mppowell/midi-controller/Layout-01.png

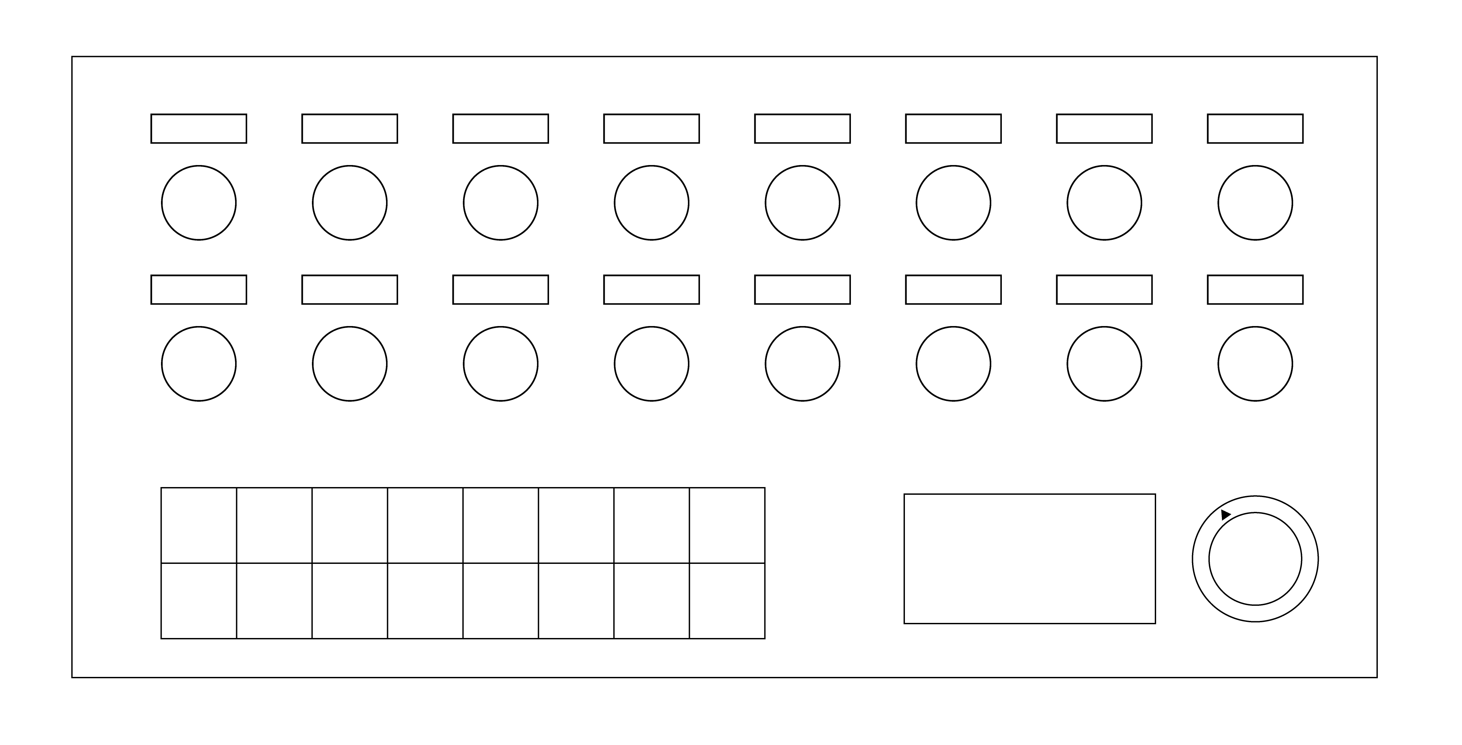
Layout-01.png
