mppowell/midi-controller/Layout_v2-01.png

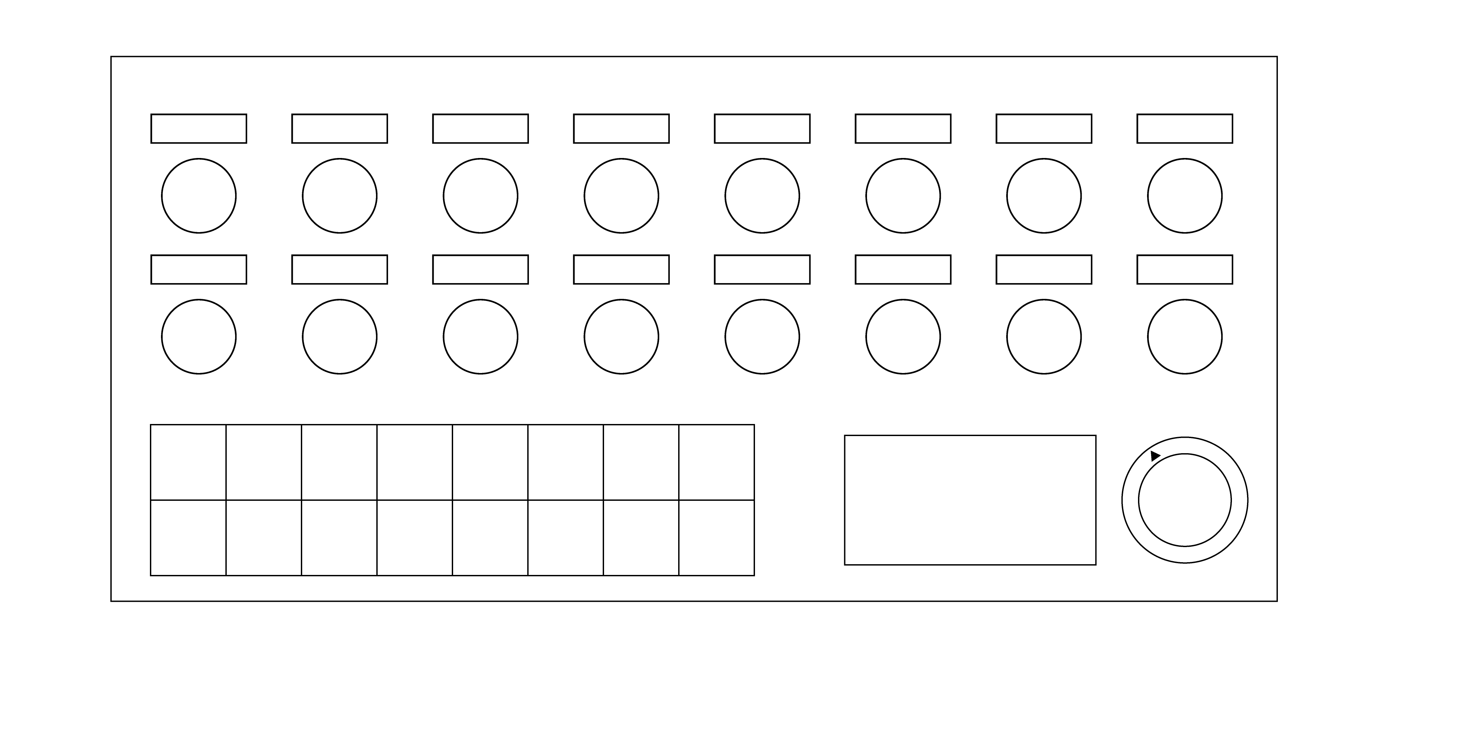
Layout_v2-01.png
