mppowell/midi-controller/PCB_Design/BOM.xlsx

# | Reference | Qty | Value | Footprint | DNP
1 | D1, D2, D3, D4, D5, D6, D7, D8, D9, D10, D11, D12, D13, D14, D15, D16, D17, D18, D19, D20, D21, D22, D23, D24 | 24 | D_Small_Filled | Diode_SMD:D_SOD-123 | x
2 | H1, H2, H3, H4, H5, H6, H7, H8 | 8 | MountingHole_Pad_M2.5 | MPP_MountingHole:MountingHole_M2.5
3 | J1, J2, J3 | 3 | Conn_01x15_Socket | Connector_FFC-FPC:Hirose_FH12-15S-0.5SH_1x15-1MP_P0.50mm_Horizontal | x
4 | J4 | 1 | Conn_01x40_Socket | Connector_FFC-FPC:Hirose_FH12-40S-0.5SH_1x40-1MP_P0.50mm_Horizontal | x
5 | RV1, RV2, RV3, RV4, RV5, RV6, RV7, RV8, RV9, RV10, RV11, RV12, RV13, RV14, RV15, RV16, RV17, RV18, RV19, RV20, RV21, RV22, RV23, RV24 | 24 | RV142FPF-40B1 | MPP_Potentiometer_THT:RV142FPF-40B1
6 | U1, U2, U3, U4, U5, U6 | 6 | TMUX1209_TSSOP | Package_SO:TSSOP-16_4.4x5mm_P0.65mm | x
7 | U7 | 1 | 74HC164 | Package_SO:SO-14_3.9x8.65mm_P1.27mm | x
8 | U8, U9 | 2 | CD74HC154_SOIC | Package_SO:SOIC-24W_7.5x15.4mm_P1.27mm | x
9 | U10 | 1 | 74LVC1G04 | Package_TO_SOT_SMD:SOT-23-5_HandSoldering | x
# | Reference | Qty | Value | Footprint | DNP
1 | A1 | 1 | Teensy_4.1_THT | MPP_Module:Teensy_4.1_THT
2 | C1 | 1 | 10uF, 50V, 20% | Capacitor_SMD:C_1210_3225Metric_Pad1.33x2.70mm_HandSolder | x
3 | C2 | 1 | 0.1uF, 25V, 5% | Capacitor_SMD:C_0805_2012Metric_Pad1.18x1.45mm_HandSolder | x
4 | C3, C4 | 2 | 22uF, 6.3V, 20% | Capacitor_SMD:C_0805_2012Metric_Pad1.18x1.45mm_HandSolder | x
5 | D1 | 1 | RED | LED_SMD:LED_0805_2012Metric_Pad1.15x1.40mm_HandSolder | x
6 | DS1 | 1 | ADAFRUIT_2IN_IPS_MODULE | MPP_Display:ADAFRUIT_2IN_IPS_MODULE | x
7 | H1, H2, H3, H4, H5, H6 | 6 | MountingHole_Pad_M2.5 | MPP_MountingHole:MountingHole_M2.5
8 | J1 | 1 | Conn_01x40_Socket | Connector_FFC-FPC:Hirose_FH12-40S-0.5SH_1x40-1MP_P0.50mm_Horizontal | x
9 | J2 | 1 | Barrel_Jack_Switch | Connector_BarrelJack:BarrelJack_Horizontal | x
10 | L1 | 1 | 4.7uH, 2.7A, 100mOhm | Inductor_SMD:L_Taiyo-Yuden_NR-60xx_HandSoldering | x
11 | R1, R2, R3, R4 | 4 | 10k | Resistor_SMD:R_0805_2012Metric_Pad1.20x1.40mm_HandSolder | x
12 | R5 | 1 | 1k | Resistor_SMD:R_0805_2012Metric_Pad1.20x1.40mm_HandSolder | x
13 | SW1 | 1 | EN16AB-HB | MPP_Rotary_Encoder:EN16AB-HB | x
14 | U1 | 1 | AP63203WU | Package_TO_SOT_SMD:TSOT-23-6 | x
# | Reference | Qty | Value | Footprint | DNP
1 | DS1, DS2, DS3, DS4, DS5, DS6, DS7, DS8 | 8 | CFAL12832C-0091B-W | MPP_Display:CFAL12832C-0091B-W
2 | H1, H2 | 2 | MountingHole_Pad_M2.5 | MPP_MountingHole:MountingHole_M2.5
3 | J1 | 1 | Conn_01x15_Socket | Connector_FFC-FPC:Hirose_FH12-15S-0.5SH_1x15-1MP_P0.50mm_Horizontal | x
