mppowell/midi-controller/PCB_Design/reference_materials/Sparkfun_PowerCircuit.png

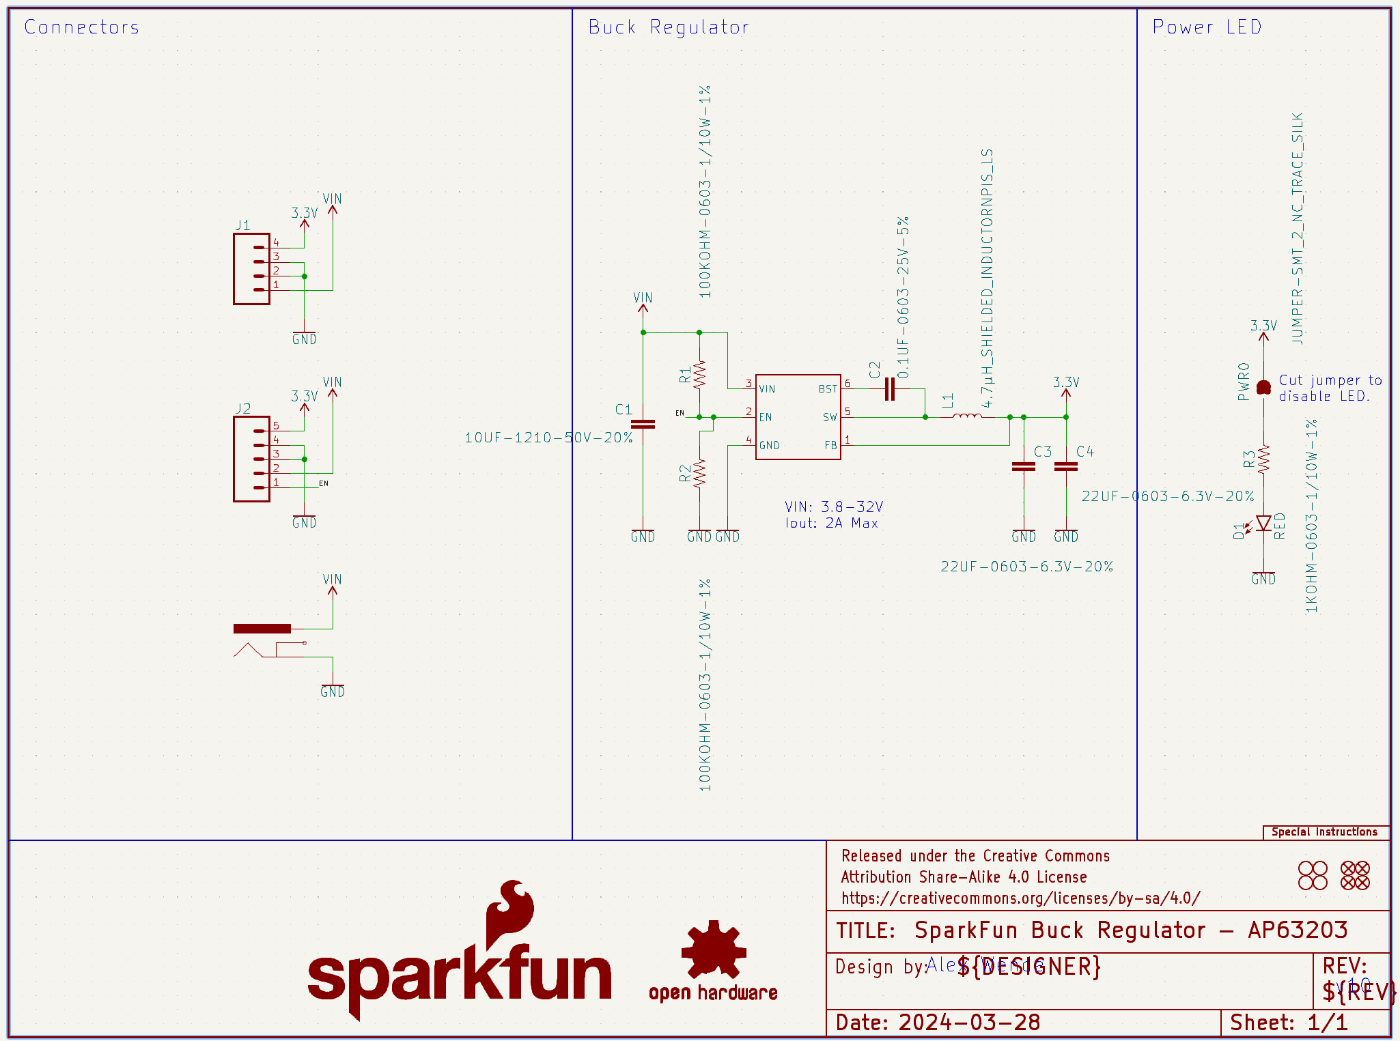
PCB_Design/reference_materials/Sparkfun_PowerCircuit.png
