mppowell/midi-controller/PCB_Models/Assembly/midi-controller_assembly-Pot.step

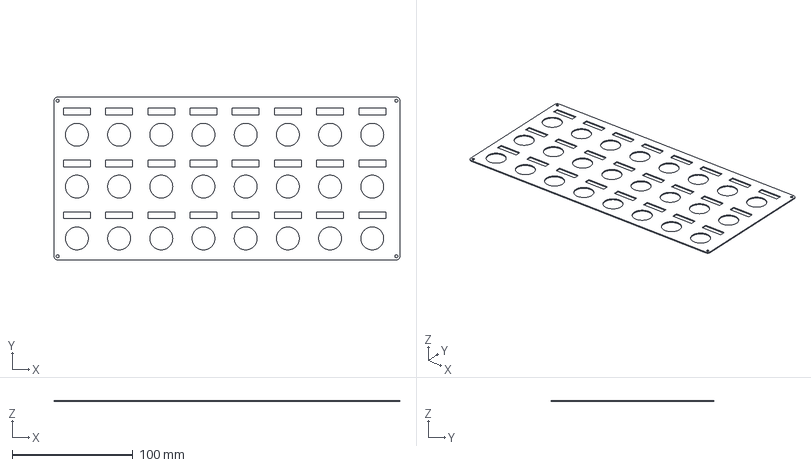
[picture p9: CAD file, 2024-06-23]
PCB_Models/Assembly/midi-controller_assembly-Pot.step
287.0 x 135.0 x 1.00 mm
