mppowell/midi-controller/PCB_Models/Assembly/midi-controller_assembly.FCStd

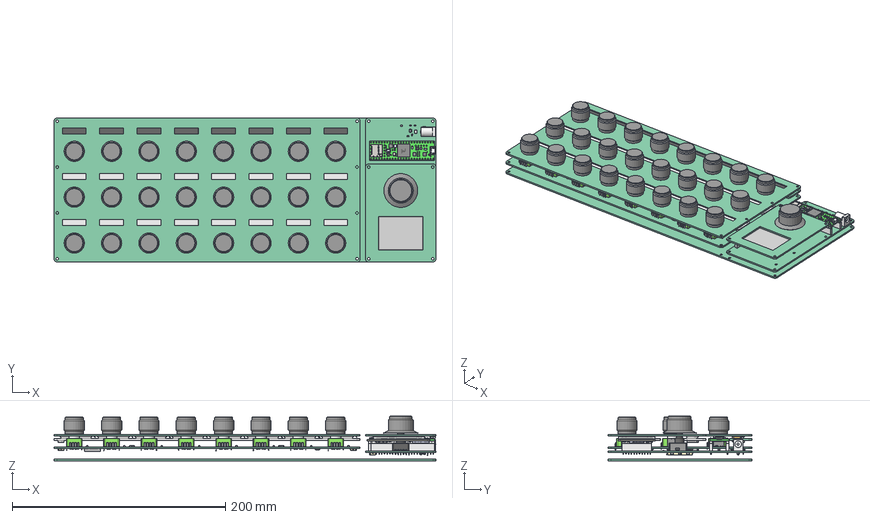
[picture p10: CAD file, 2024-06-23]
PCB_Models/Assembly/midi-controller_assembly.FCStd
358.0 x 135.0 x 41.9 mm
Pcb_732a
Panel x 8
Display x 8
Cable x 8
FoamPad x 8
lock x 8
pins x 8
lock001
pins001
midi-controller_oled-board_teensy001
midi-controller_oled-board_teensy002
Pcb_85c2
Pcb_93cb
Pcb_7e6a
PCB, Teensy 4.1
SMD Capacitor, Configurable, Teensy 4.1_C8
SMD Capacitor, Configurable, Teensy 4.1_C009
SMD Capacitor, Configurable, Teensy 4.1_C010
SMD Capacitor, Configurable, Teensy 4.1_C9
SMD Capacitor, Configurable, Teensy 4.1_C012
SMD Capacitor, Configurable, Teensy 4.1_C013
SMD Capacitor, Configurable, Teensy 4.1_C29
SMD Capacitor, Configurable, Teensy 4.1_C015
SMD Capacitor, Configurable, Teensy 4.1_C016
SMD Capacitor, Configurable, Teensy 4.1_C13
SMD Capacitor, Configurable, Teensy 4.1_C018
SMD Capacitor, Configurable, Teensy 4.1_C019
SMD Capacitor, Configurable, Teensy 4.1_C12
SMD Capacitor, Configurable, Teensy 4.1_C021
SMD Capacitor, Configurable, Teensy 4.1_C022
SMD Capacitor, Configurable, Teensy 4.1_C6
SMD Capacitor, Configurable, Teensy 4.1_C024
SMD Capacitor, Configurable, Teensy 4.1_C025
SMD Capacitor, Configurable, Teensy 4.1_C5
SMD Capacitor, Configurable, Teensy 4.1_C027
SMD Capacitor, Configurable, Teensy 4.1_C028
SMD Capacitor, Configurable, Teensy 4.1_C11
SMD Capacitor, Configurable, Teensy 4.1_C030
SMD Capacitor, Configurable, Teensy 4.1_C031
SMD Capacitor, Configurable, Teensy 4.1_C22
SMD Capacitor, Configurable, Teensy 4.1_C033
SMD Capacitor, Configurable, Teensy 4.1_C034
SMD Capacitor, Configurable, Teensy 4.1_C23
SMD Capacitor, Configurable, Teensy 4.1_C036
SMD Capacitor, Configurable, Teensy 4.1_C037
SMD Capacitor, Configurable, Teensy 4.1_C14
SMD Capacitor, Configurable, Teensy 4.1_C039
SMD Capacitor, Configurable, Teensy 4.1_C040
SMD Capacitor, Configurable, Teensy 4.1_C16
SMD Capacitor, Configurable, Teensy 4.1_C042
SMD Capacitor, Configurable, Teensy 4.1_C043
SMD Capacitor, Configurable, Teensy 4.1_C17
SMD Capacitor, Configurable, Teensy 4.1_C045
SMD Capacitor, Configurable, Teensy 4.1_C046
SMD Capacitor, Configurable, Teensy 4.1_C20
SMD Capacitor, Configurable, Teensy 4.1_C048
SMD Capacitor, Configurable, Teensy 4.1_C049
SMD Capacitor, Configurable, Teensy 4.1_C21
SMD Capacitor, Configurable, Teensy 4.1_C051
SMD Capacitor, Configurable, Teensy 4.1_C052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
