mppowell/midi-controller/PCB_Models/Adafruit_2_IPS/3D/4311 2in TFT IPS Display.step

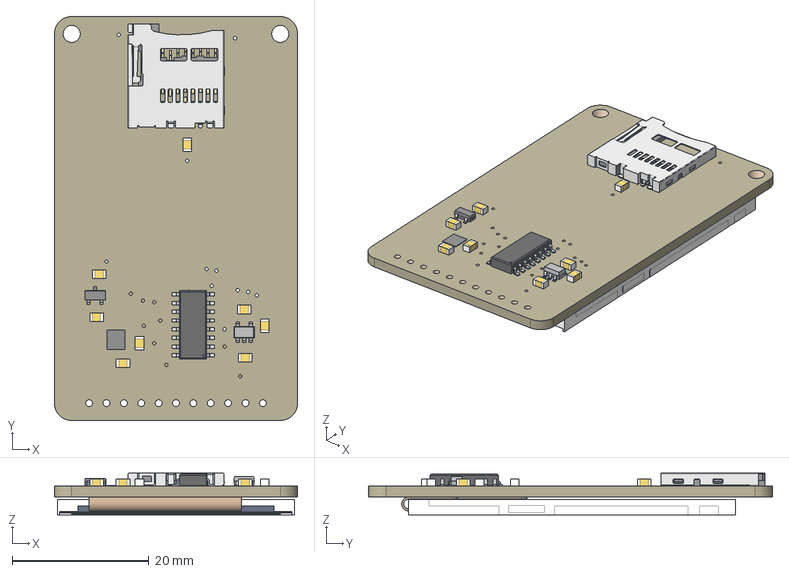
[picture p11: CAD file, 2024-06-23]
PCB_Models/Adafruit_2_IPS/3D/4311 2in TFT IPS Display.step
35.6 x 59.1 x 6.08 mm
Board
10K x 8
AP2112K-3.3
74HC4050D
MICROSD
BSS138
DISP_LCD_GENERIC_SPI_2.0IN_240X320
APX803-SAG
