mppowell/midi-controller/PCB_Models/Assembly/Faceplate.FCStd

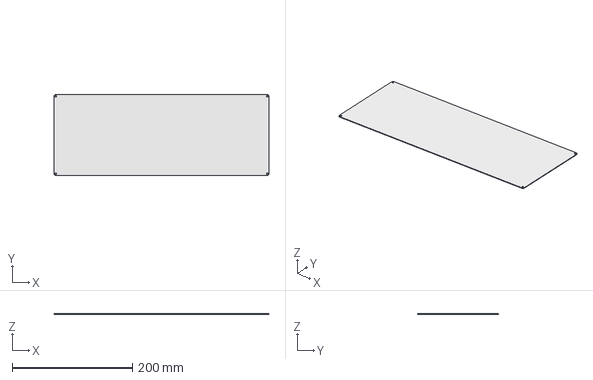
[picture p12: CAD file, 2024-06-23]
PCB_Models/Assembly/Faceplate.FCStd
358.0 x 135.0 x 1.00 mm
