mppowell/midi-controller/PCB_Models/Adafruit_2.8TFT Grabcad/Adafruit 2.8TFT.STEP

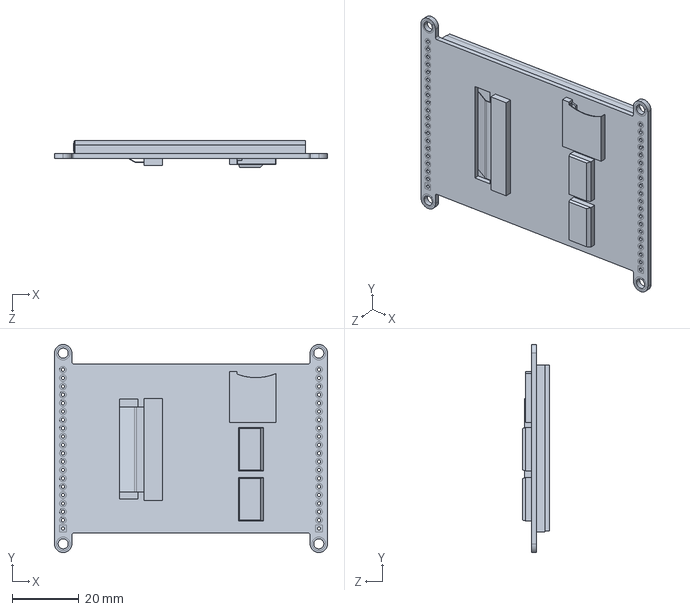
[picture p13: CAD file, 2024-06-23]
PCB_Models/Adafruit_2.8TFT Grabcad/Adafruit 2.8TFT.STEP
81.7 x 62.2 x 8.00 mm
