mppowell/midi-controller/(list of files, cad)

Other CAD files:
PCB_Models/Adafruit_2.8TFT Grabcad/Adafruit 2.8TFT.SLDPRT
PCB_Models/Adafruit_2_IPS/3D/4311 2in TFT IPS Display.f3d
PCB_Models/Adafruit_2_IPS/3D/4311 2in TFT IPS Display.stl
