mppowell/midi-controller/(threads)

Thread 1 (2024-08-12):

Limited number of OLED screens working at once

mppowell, 2024-08-12:
When attaching a single row of OLED displays (using version 1 of the OLED board), the displays work as intended. However, when I attached a 2nd or 3rd row of OLEDs, none of them would turn on.

mppowell, 2024-08-12:
To test if it was a problem with the whole OLED board, I added one OLED to the second row at a time. After 4-5 OLEDs in the second row, the displays started to glitch. So it didn't seem to be a problem inherent to having 2 rows hooked up to the mainboard, but rather a limitation on the number of OLEDs that could be connected at once.

mppowell, 2024-08-12:
I reduced the data rate of the SPI bus to see if a slower signal would be more robust. I got more screens working at once, and was able to get something to show up on all the screens but the data still looked corrupted. This strengthens my opinion that the issue has to do with loading on the SPI lines.

mppowell, 2024-08-12:
To resolve this issue, I redesigned the OLED board to include a buffer on the SPI lines and increase the impedance seen by the microcontroller pins.

Thread 2 (2024-08-12):

OLED board version 2 does not display more than 1 row at a time

mppowell, 2024-08-12:
After redesigning the OLED board to resolve previous issue, I again found that connecting the second row of OLEDs resulted in none of the OLEDs working properly. They would produce a strange, corrupted text, and nothing showed up on the IPS display (which led me ultimately to the answer). When I would turn the page selection encoder, the text would shift by a regular amount each time I would flip it back. This no longer seemed like SPI corruption but rather that the cursor or display size was getting mishandled.
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

mppowell, 2024-08-12:
When I commented out all code related to the IPS display, I discovered that all the OLEDs actually worked! This eliminated the idea that the issue was related to SPI corruption and it eliminated concerns over there not being sufficient power to turn on the screens. When I started to add IPS functionality back in, the OLEDs broke again almost immediately. Even just initializing the IPS display caused the corrupted view to return.

Interestingly, during this initialization, the screen resolution is configured. And the IPS screen resolution is different from that of the OLED screens. Both libraries, call the Adafruit_GFX library, so I wondered if perhaps a global variable related to the screen resolution was being overwritten that caused the cursor to end up in the wrong position for the OLEDs each time they got overwritten.

mppowell, 2024-08-12:
I discovered the bug which took 2 critical steps. First, when initializing the IPS display, I needed to put it into "SPI_MODE2" (by default it is set to SPI_MODE0). However, I can't find anywhere in the documentation for this display that it uses SPI_MODE2, nor did it have any issue in SPI_MODE0 when used alone, or even with one row of the OLEDs. So I don't fully understand why this worked.

This worked, but resulted in the box showing the selected page on the menu, not to be reset when changing the page. To resolve this issue, I had to re-call the set-rotation function each time I updated the IPS display. I assume this puts the cursor in the correct spot before making any changes.

The issue is resolved, but I am not entirely sure why...

Closed 2024-08-12.
