mppowell/midi-controller/PCB_Illustrations/midi-controller_pot-subcircuit_diagram/midi-controller_pot-subcircuit_diagram.kicad_pcb

## KiCad design ECB_FirstDraftSchematic/ECB_FirstDraft.kicad_sch

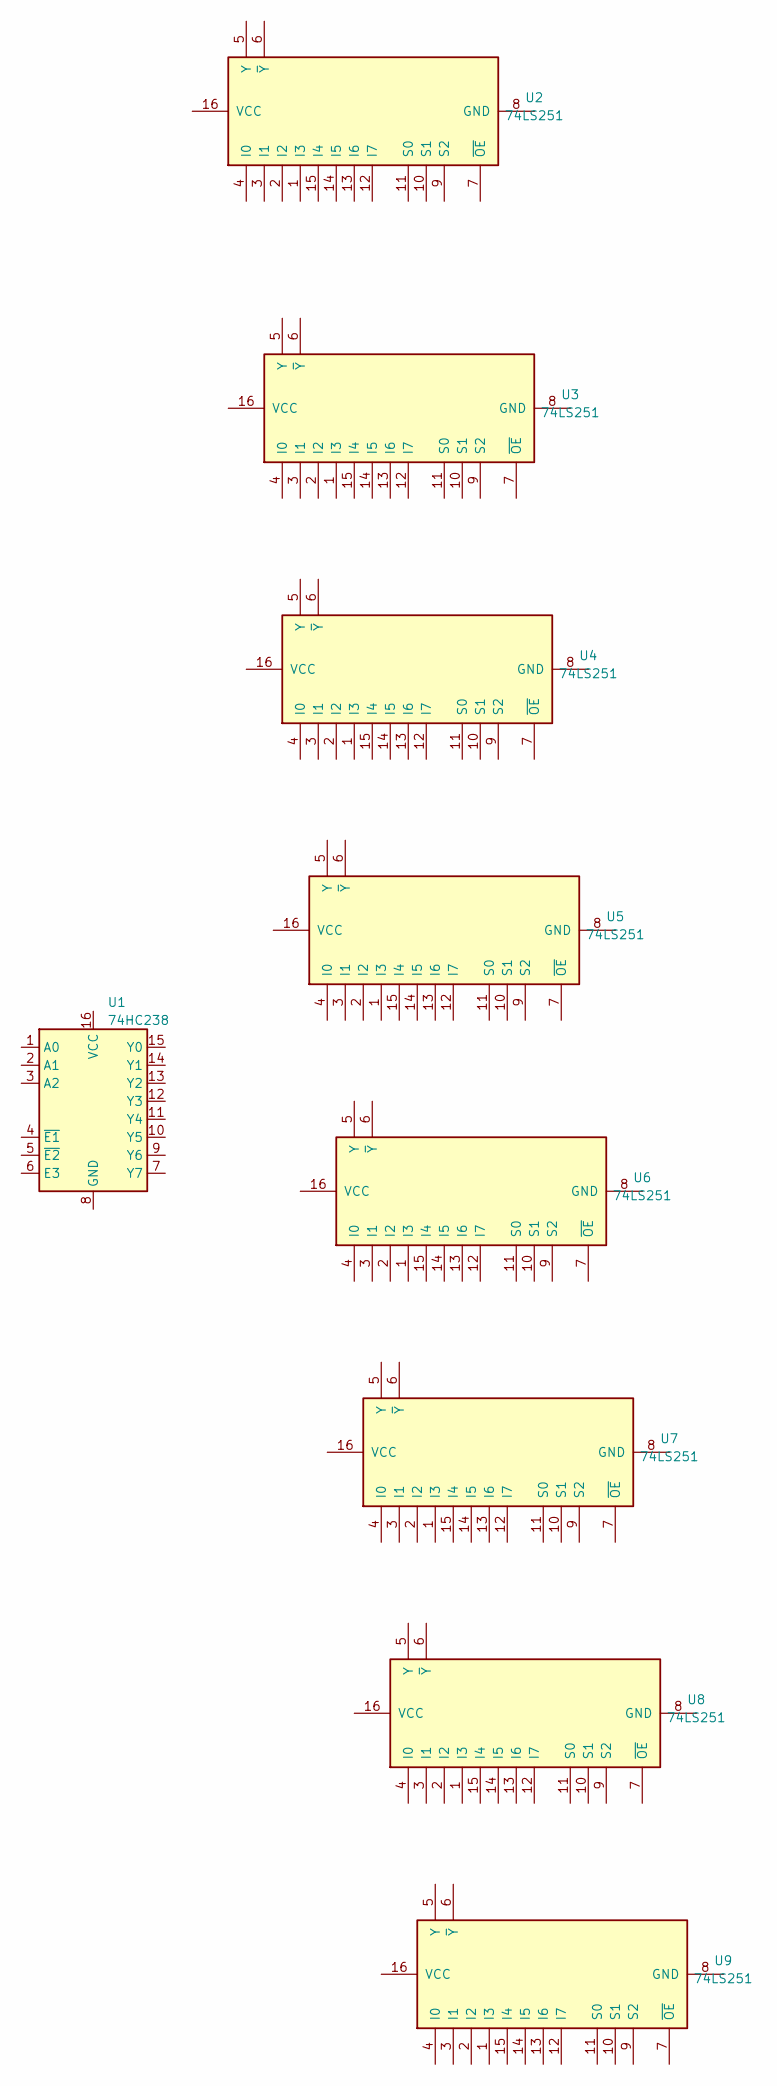
[picture p14: schematic ECB_FirstDraft.kicad_sch]

Parts:
U1: 74HC238
U2, U3, U4, U5, U6, U7, U8, U9: 74LS251
