mppowell/midi-controller/PCB_Models/Adafruit_2_IPS/Eagle/Adafruit-2.0-inch-240x320-TFT-PCB-master/Adafruit-2.0-inch-240x320-TFT-PCB-master/Adafruit 2.0 inch 240x320 IPS TFT.brd

## EAGLE design PCB_Models/Adafruit_2_IPS/Eagle/Adafruit-2.0-inch-240x320-TFT-PCB-master/Adafruit-2.0-inch-240x320-TFT-PCB-master/Adafruit 2.0 inch 240x320 IPS TFT.brd (2024-06-23)

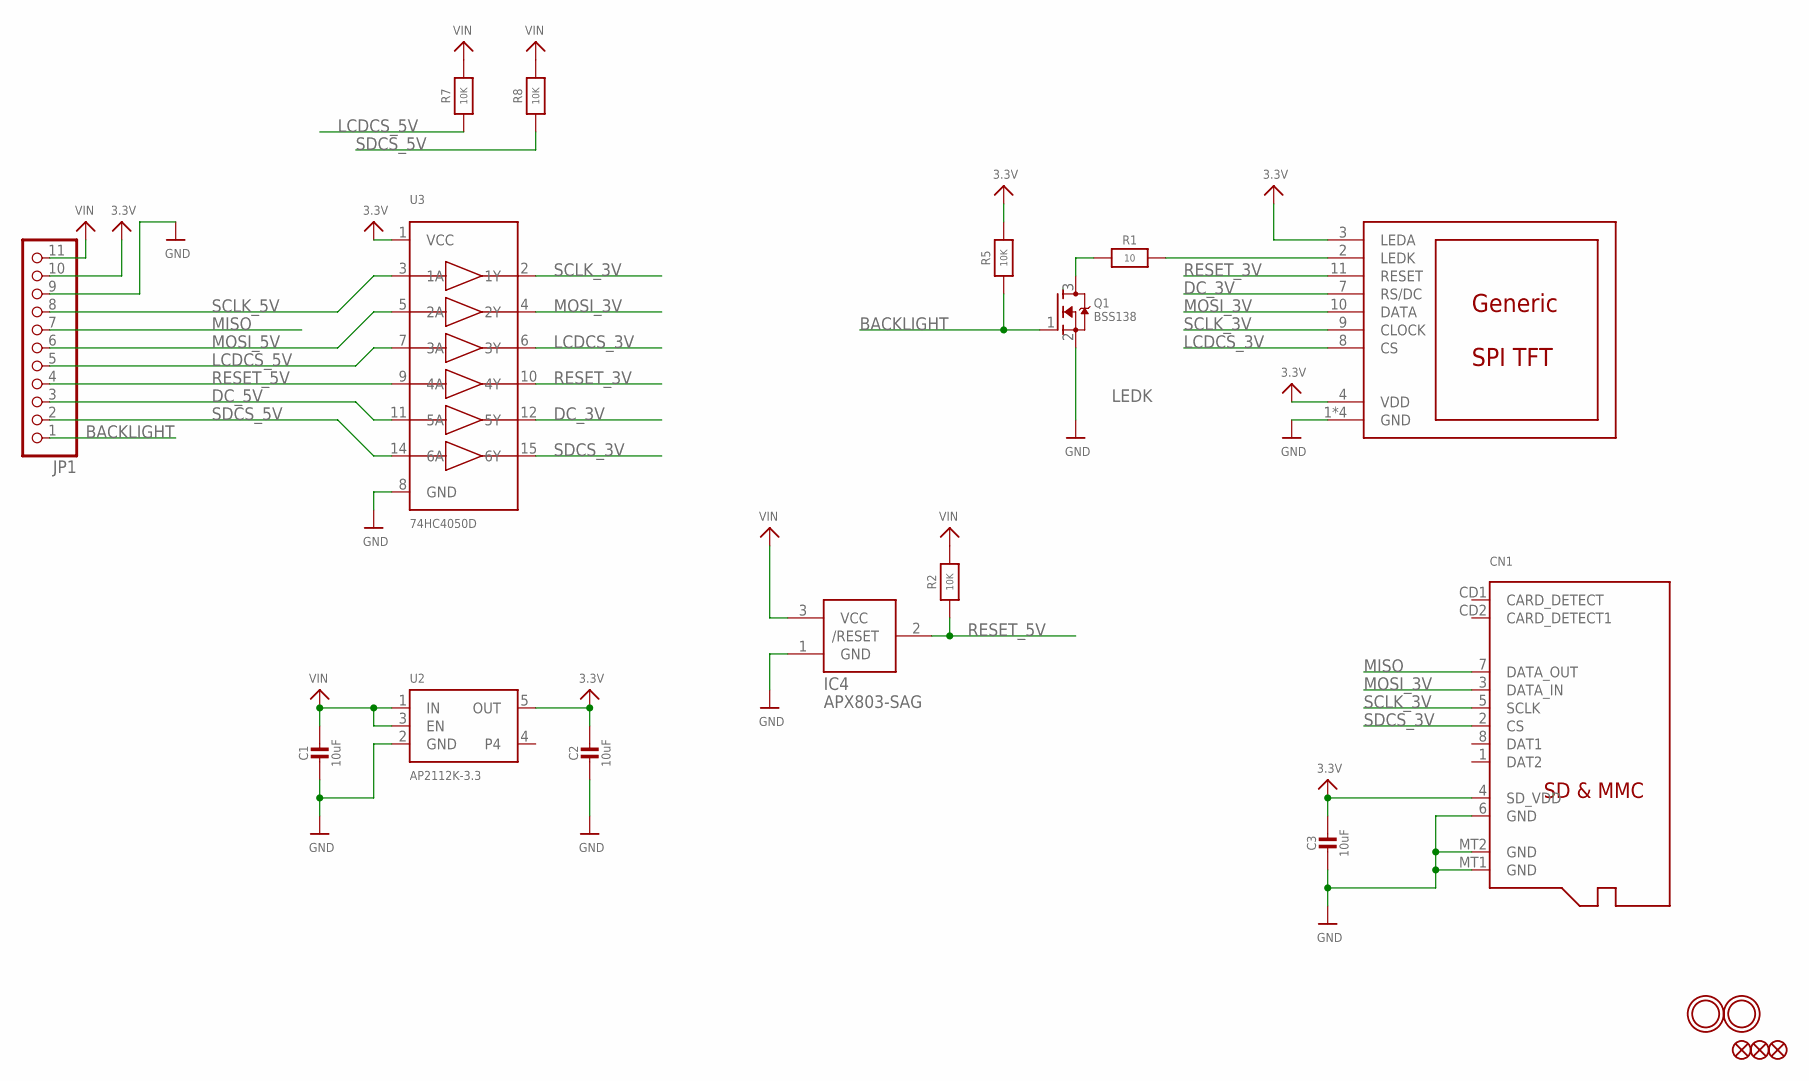
[picture p15: schematic Adafruit 2.0 inch 240x320 IPS TFT.sch]

Parts:
C1, C2, C3: 10uF; 0805-NO
CN1: MICROSD
DISP1: DISP_LCD_GENERIC_SPI_2.0IN_240X320; TFT_2.0IN_240X320_12P
FID1, FID2, FID3: FIDUCIAL_1MM
IC4: APX803-SAG; SOT23
JP1: HEADER-1X1176MIL; 1X11_ROUND_76
Q1: BSS138; SOT23-R
R1: 10; 0805-NO
R2, R5, R7, R8: 10K; 0805-NO
U2: AP2112K-3.3; SOT23-5
U3: 74HC4050D; SOIC16
U$3, U$4: MOUNTINGHOLE2.5; MOUNTINGHOLE_2.5_PLATED

Connections:
3.3V: C2.1, C3.1, CN1.4 (SD_VDD), DISP1.3 (LEDA), DISP1.4 (VDD), JP1.10, R5.2, U2.5 (OUT), U3.1 (VCC)
BACKLIGHT: JP1.1, Q1.1 (G), R5.1
DC_3V: DISP1.7 (RS/DC), U3.12 (5Y)
DC_5V: JP1.3, U3.11 (5A)
GND: C1.2, C2.2, C3.2, CN1.6 (GND), CN1.MT1 (GND), CN1.MT2 (GND), DISP1.1 (GND), DISP1.5 (GND), DISP1.6 (GND), DISP1.12 (GND), IC4.1 (GND), JP1.9, Q1.2 (S), U2.2 (GND), U3.8 (GND)
LCDCS_3V: DISP1.8 (CS), U3.6 (3Y)
LCDCS_5V: JP1.5, R7.1, U3.7 (3A)
LEDK: Q1.3 (D), R1.1
MISO: CN1.7 (DATA_OUT), JP1.7
MOSI_3V: CN1.3 (DATA_IN), DISP1.10 (DATA), U3.4 (2Y)
MOSI_5V: JP1.6, U3.5 (2A)
unnamed: DISP1.2 (LEDK), R1.2
RESET_3V: DISP1.11 (RESET), U3.10 (4Y)
RESET_5V: IC4.2 (/RESET), JP1.4, R2.1, U3.9 (4A)
SCLK_3V: CN1.5 (SCLK), DISP1.9 (CLOCK), U3.2 (1Y)
SCLK_5V: JP1.8, U3.3 (1A)
SDCS_3V: CN1.2 (CS), U3.15 (6Y)
SDCS_5V: JP1.2, R8.1, U3.14 (6A)
VIN: C1.1, IC4.3 (VCC), JP1.11, R2.2, R7.2, R8.2, U2.1 (IN), U2.3 (EN)

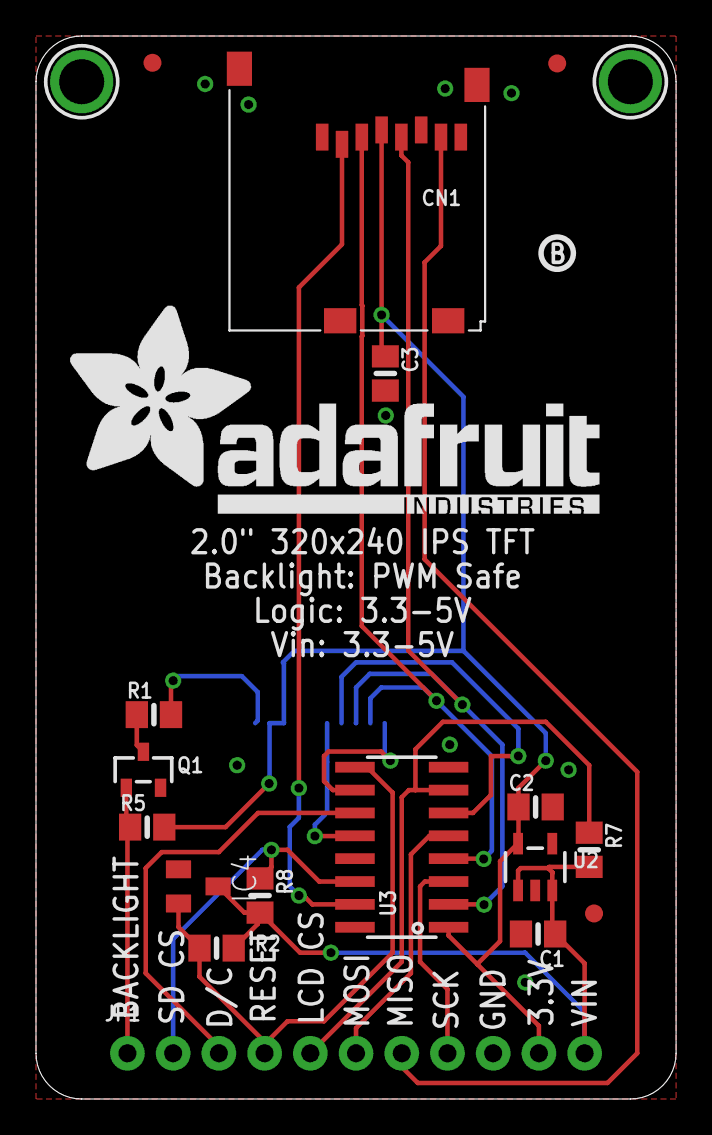
[picture p16: board Adafruit 2.0 inch 240x320 IPS TFT.brd from above]

Board: 2 copper layers, 35.6 x 59.1 mm, 22 parts (1 on the bottom side), 19 nets.

Other parts of the board:
U$20: ADAFRUIT_TEXT_30MM
U$24: PCBFEAT-REV-040
