mppowell/midi-controller/PCB_Models/Adafruit_2_IPS/Eagle/Adafruit-2.0-inch-240x320-TFT-PCB-master/Adafruit-2.0-inch-240x320-TFT-PCB-master/Adafruit EYESPI 2.0 Inch 240x320 IPS TFT.brd

## EAGLE design PCB_Models/Adafruit_2_IPS/Eagle/Adafruit-2.0-inch-240x320-TFT-PCB-master/Adafruit-2.0-inch-240x320-TFT-PCB-master/Adafruit EYESPI 2.0 Inch 240x320 IPS TFT.brd (2024-06-23)

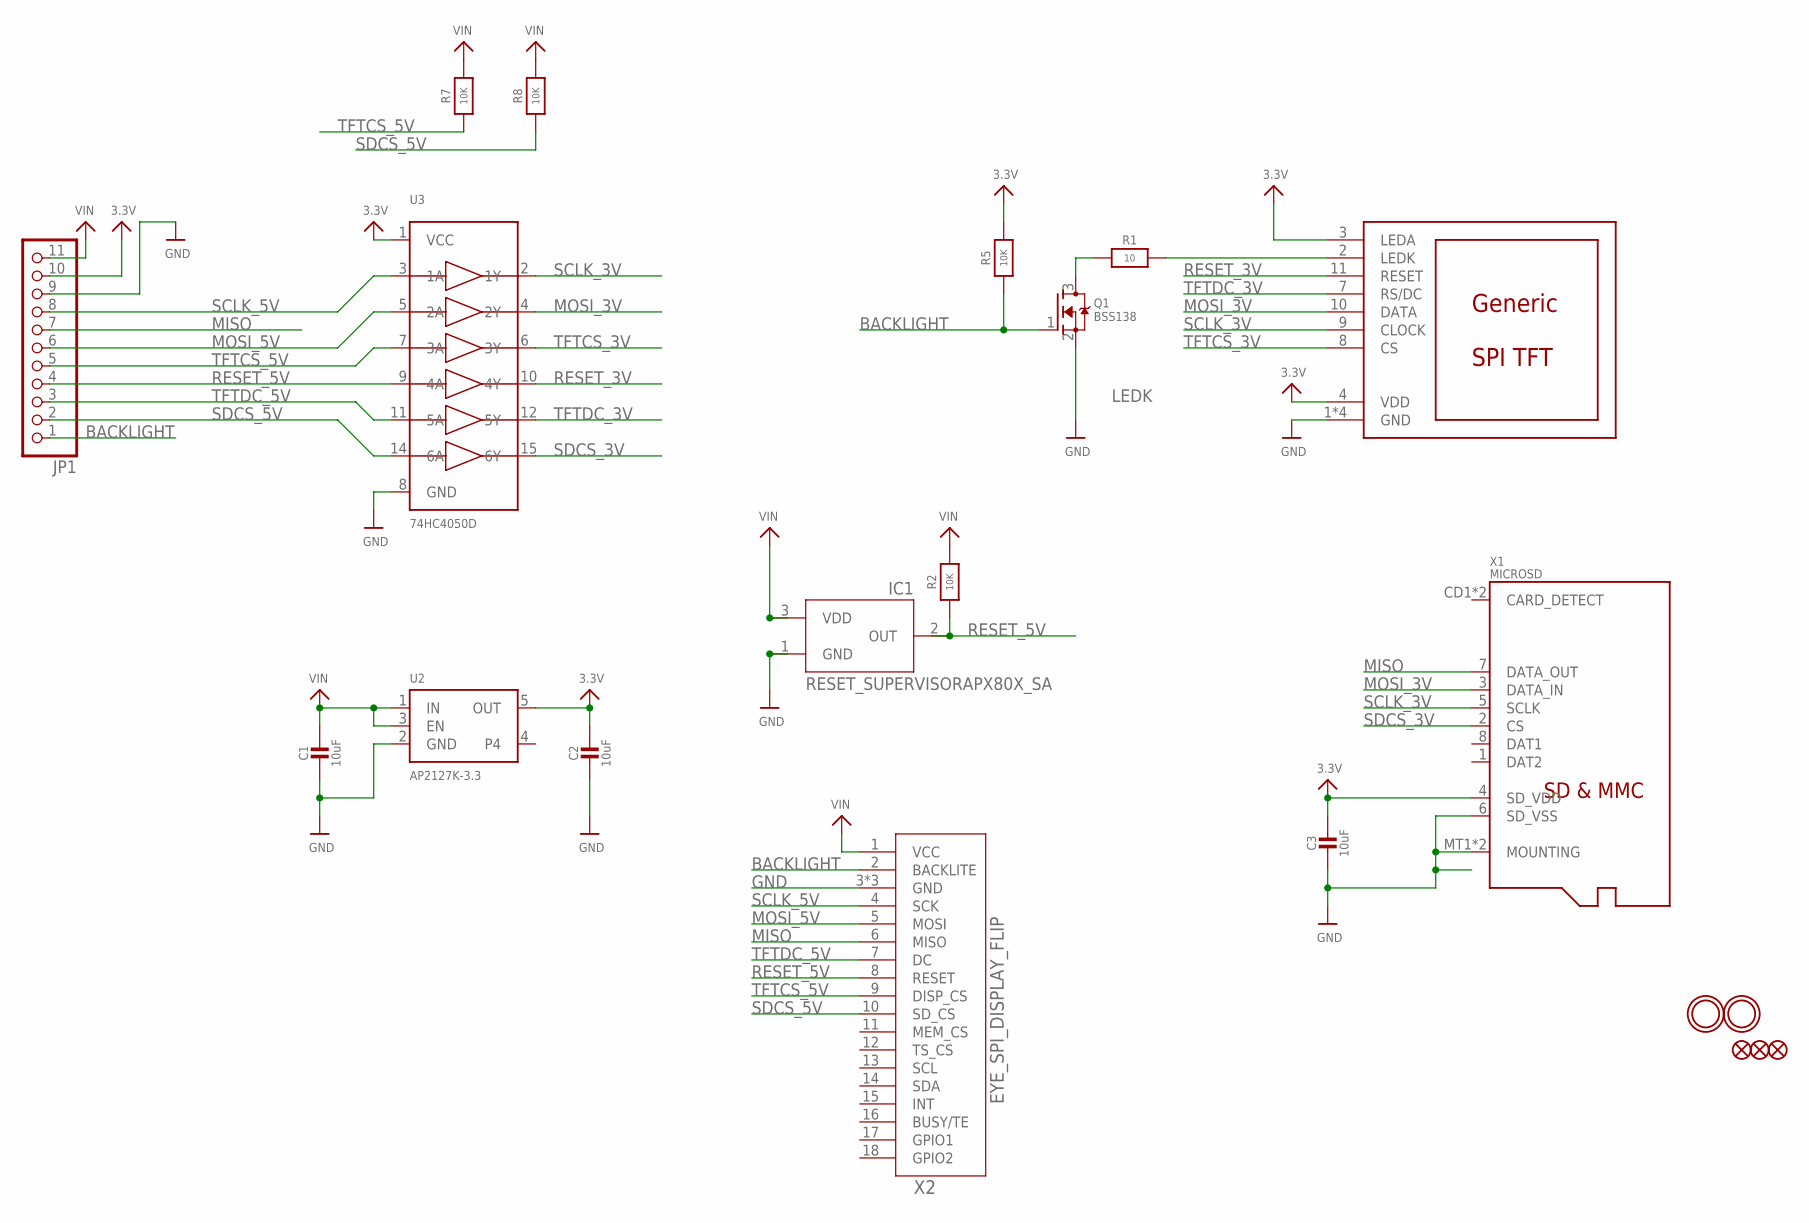
[picture p17: schematic Adafruit EYESPI 2.0 Inch 240x320 IPS TFT.sch]

Parts:
C1, C2, C3: 10uF; 0805-NO
DISP1: DISP_LCD_GENERIC_SPI_2.0IN_240X320; TFT_2.0IN_240X320_12P
FID1, FID2, FID3: FIDUCIAL_1MM
IC1: RESET_SUPERVISORAPX80X_SA; SOT23-WIDE
JP1: HEADER-1X1176MIL; 1X11_ROUND_76
Q1: BSS138; SOT23-R
R1: 10; 0805-NO
R2, R5, R7, R8: 10K; 0805-NO
U2: AP2127K-3.3; SOT23-5
U3: 74HC4050D; SOIC16
U$3, U$4: MOUNTINGHOLE2.5; MOUNTINGHOLE_2.5_PLATED
X1: MICROSD
X2: EYE_SPI_DISPLAY_FLIP; EYE_SPI_DISPLAY_BOTCONTACT

Connections:
3.3V: C2.1, C3.1, DISP1.3 (LEDA), DISP1.4 (VDD), JP1.10, R5.2, U2.5 (OUT), U3.1 (VCC), X1.4 (SD_VDD)
BACKLIGHT: JP1.1, Q1.1 (G), R5.1, X2.2 (BACKLITE)
GND: C1.2, C2.2, C3.2, DISP1.1 (GND), DISP1.5 (GND), DISP1.6 (GND), DISP1.12 (GND), IC1.1 (GND), JP1.9, Q1.2 (S), U2.2 (GND), U3.8 (GND), X1.6 (SD_VSS), X1.MT1 (MOUNTING), X1.MT2 (MOUNTING), X2.3 (GND), X2.SUPPORT1 (GND), X2.SUPPORT2 (GND)
LEDK: Q1.3 (D), R1.1
MISO: JP1.7, X1.7 (DATA_OUT), X2.6 (MISO)
MOSI_3V: DISP1.10 (DATA), U3.4 (2Y), X1.3 (DATA_IN)
MOSI_5V: JP1.6, U3.5 (2A), X2.5 (MOSI)
unnamed: DISP1.2 (LEDK), R1.2
RESET_3V: DISP1.11 (RESET), U3.10 (4Y)
RESET_5V: IC1.2 (OUT), JP1.4, R2.1, U3.9 (4A), X2.8 (RESET)
SCLK_3V: DISP1.9 (CLOCK), U3.2 (1Y), X1.5 (SCLK)
SCLK_5V: JP1.8, U3.3 (1A), X2.4 (SCK)
SDCS_3V: U3.15 (6Y), X1.2 (CS)
SDCS_5V: JP1.2, R8.1, U3.14 (6A), X2.10 (SD_CS)
TFTCS_3V: DISP1.8 (CS), U3.6 (3Y)
TFTCS_5V: JP1.5, R7.1, U3.7 (3A), X2.9 (DISP_CS)
TFTDC_3V: DISP1.7 (RS/DC), U3.12 (5Y)
TFTDC_5V: JP1.3, U3.11 (5A), X2.7 (DC)
VIN: C1.1, IC1.3 (VDD), JP1.11, R2.2, R7.2, R8.2, U2.1 (IN), U2.3 (EN), X2.1 (VCC)

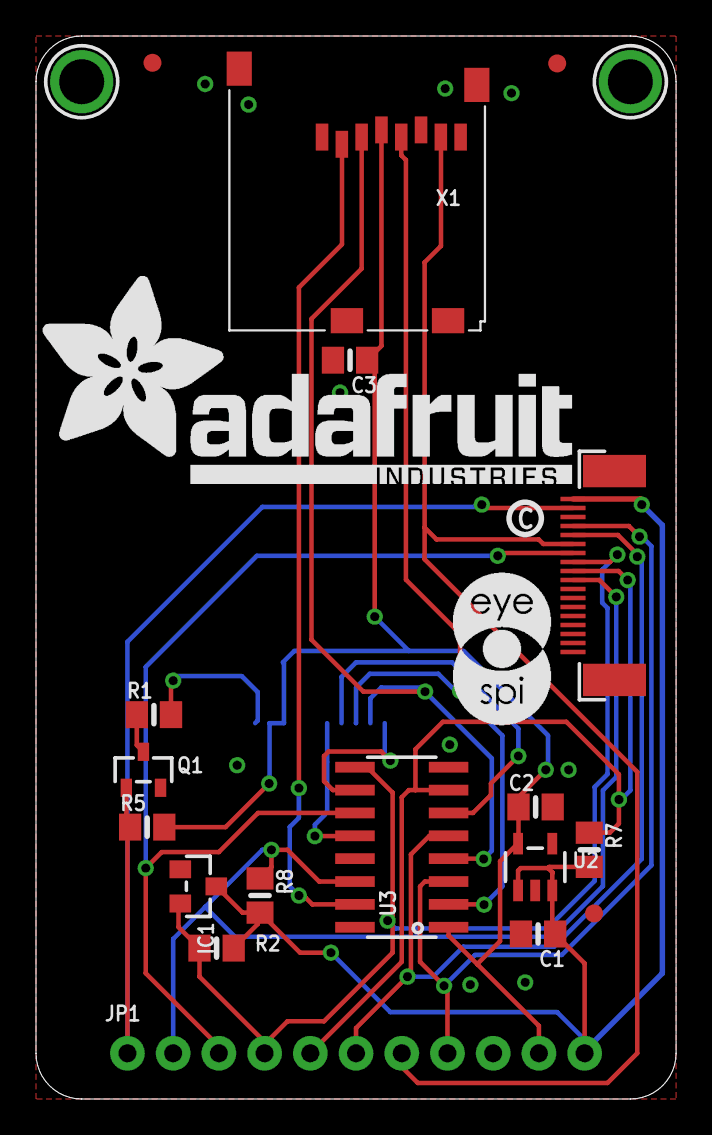
[picture p18: board Adafruit EYESPI 2.0 Inch 240x320 IPS TFT.brd from above]

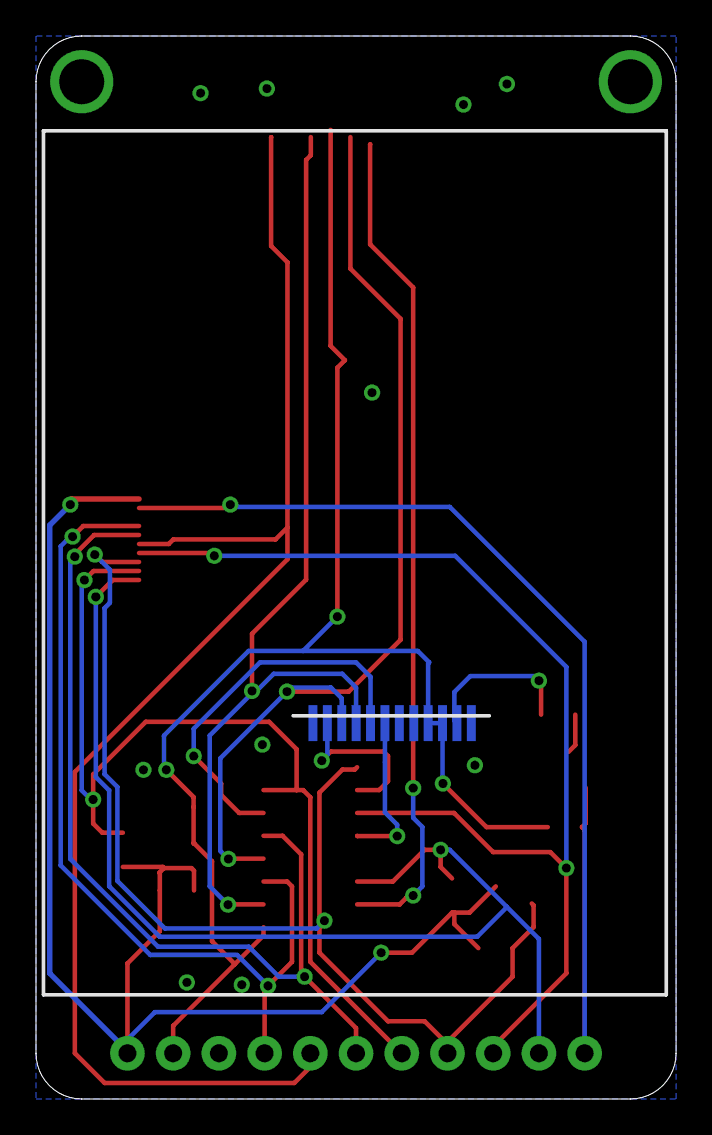
[picture p19: board Adafruit EYESPI 2.0 Inch 240x320 IPS TFT.brd from below]

Board: 2 copper layers, 35.6 x 59.1 mm, 48 parts (13 on the bottom side), 19 nets.

Other parts of the board:
PLABEL0: PLABEL0
PLABEL1: PLABEL1
PLABEL2: PLABEL2
PLABEL3: PLABEL3
PLABEL4: PLABEL4
PLABEL5: PLABEL5
PLABEL6: PLABEL6
PLABEL7: PLABEL7
PLABEL8: PLABEL8
PLABEL9: PLABEL9
PLABEL10: PLABEL10
PLABEL11: PLABEL11
PLABEL12: PLABEL12
PLABEL13: PLABEL13
PLABEL14: PLABEL14
PLABEL15: PLABEL15
PLABEL16: PLABEL16
PLABEL17: PLABEL17
PLABEL18: PLABEL18
PLABEL19: PLABEL19
PLABEL20: PLABEL20
PLABEL21: PLABEL21
PLABEL22: PLABEL22
PLABEL23: PLABEL23
U$20: ADAFRUIT_TEXT_30MM
U$24: PCBFEAT-REV-040
U$28: EYESPI_MINI_LOGO
