mppowell/midi-controller/(commit log)

2023-08-27 Uploaded test arduino code developed for potentiometers
2023-08-28 Got arduino talking to lightroom with one encoder
2024-06-23 Finished circuit design and initial firmware for Teensy
    [4311 2in TFT IPS Display.f3d, 4311 2in TFT IPS Display.step, 4311 2in TFT IPS Display.stl, Adafruit 2.0 inch 240x320 IPS TFT.brd, Adafruit 2.0 inch 240x320 IPS TFT.sch, Adafruit 2.8TFT.SLDPRT, Adafruit 2.8TFT.STEP, Adafruit EYESPI 2.0 Inch 240x320 IPS TFT.brd]
2024-08-12 Resolves bug when connecting more than one OLED version 2 board
    Fixes: #2
    [actual-circuit.kicad_sch, full-scale.kicad_sch, midi-controller_pot-subcircuit_diagram.kicad_pcb, midi-controller_pot-subcircuit_diagram.kicad_sch, multi-channel.kicad_sch, single-channel.kicad_sch]
2024-09-17 Added an "off" position for the encoder to turn off the OLED screens and IPS display when not in use
